pingud98/OpenAutoChPiHat/README.md

# OpenAutoChPiHat
A Raspberry Pi Hat designed for open hardware and open software car sharing

It's now featured in the SEEED fusion gallery: https://www.seeedstudio.com/Open-Car-Sharing-Hardware-Module-OpenAuto-c-g-1036303
