pingud98/OpenAutoChPiHat/openautopihatv1point2x.pdf

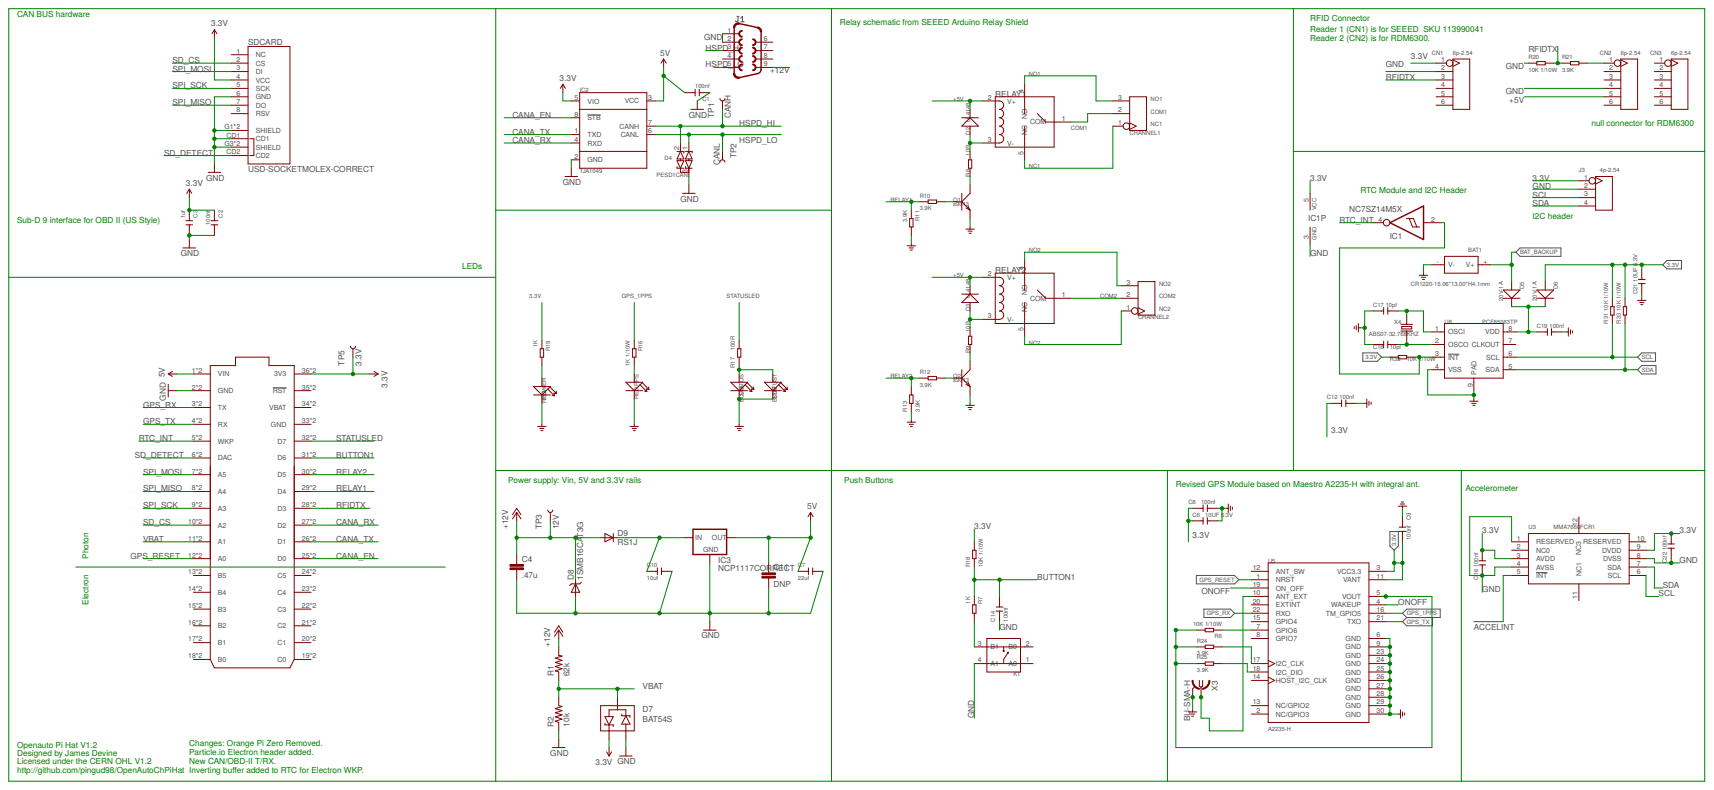
[picture p1: page 1]

USD-SOCKETMOLEX-CORRECT GND

Sub-D 9 interface for OBD II (US Style)

Revised GPS Module based on Maestro A2235-H with integral ant.

http://github.com/pingud98/OpenAutoChPiHat Changes: Orange Pi Zero Removed. Particle.io Electron header added. New CAN/OBD-II T/RX.
Openauto Pi Hat V1.2 Designed by James Devine
Licensed under the CERN OHL V1.2

Inverting buffer added to RTC for Electron WKP.
