pingud98/OpenAutoChPiHat/openautopihatv1point1brd.pdf

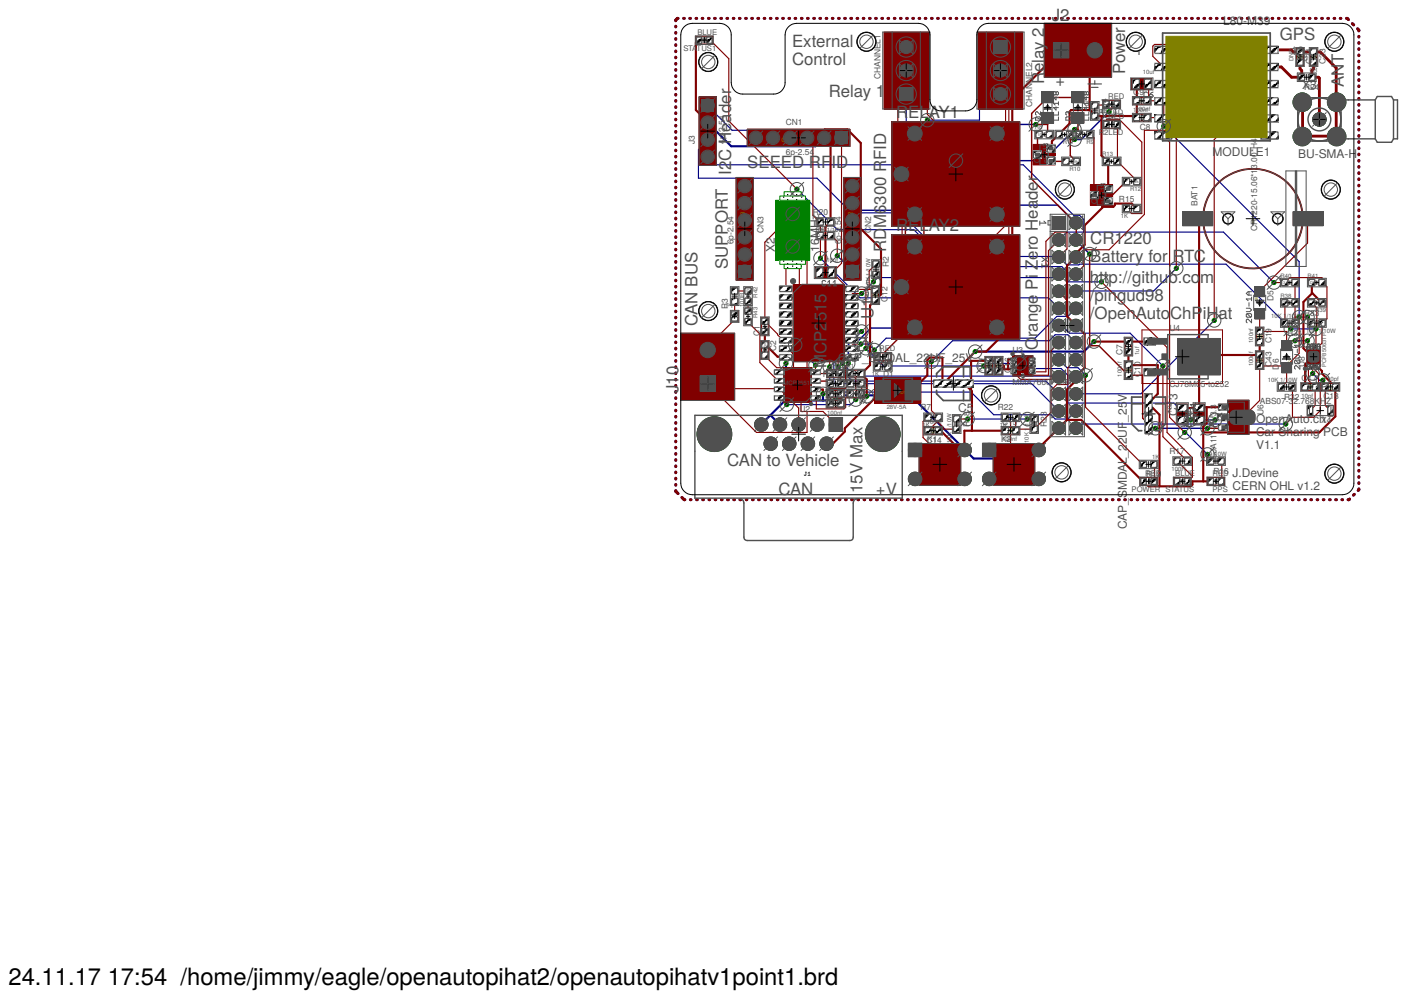
[picture p2: page 1]

Orange Pi Zero Header

3.9k | DNP

RED R1

OpenAuto.ch Car Sharing PCB
J.Devine CERN OHL v1.2

24.11.17 17:54 /home/jimmy/eagle/openautopihat2/openautopihatv1point1.brd
