pingud98/OpenAutoChPiHat/openautopihatv1point1.pdf

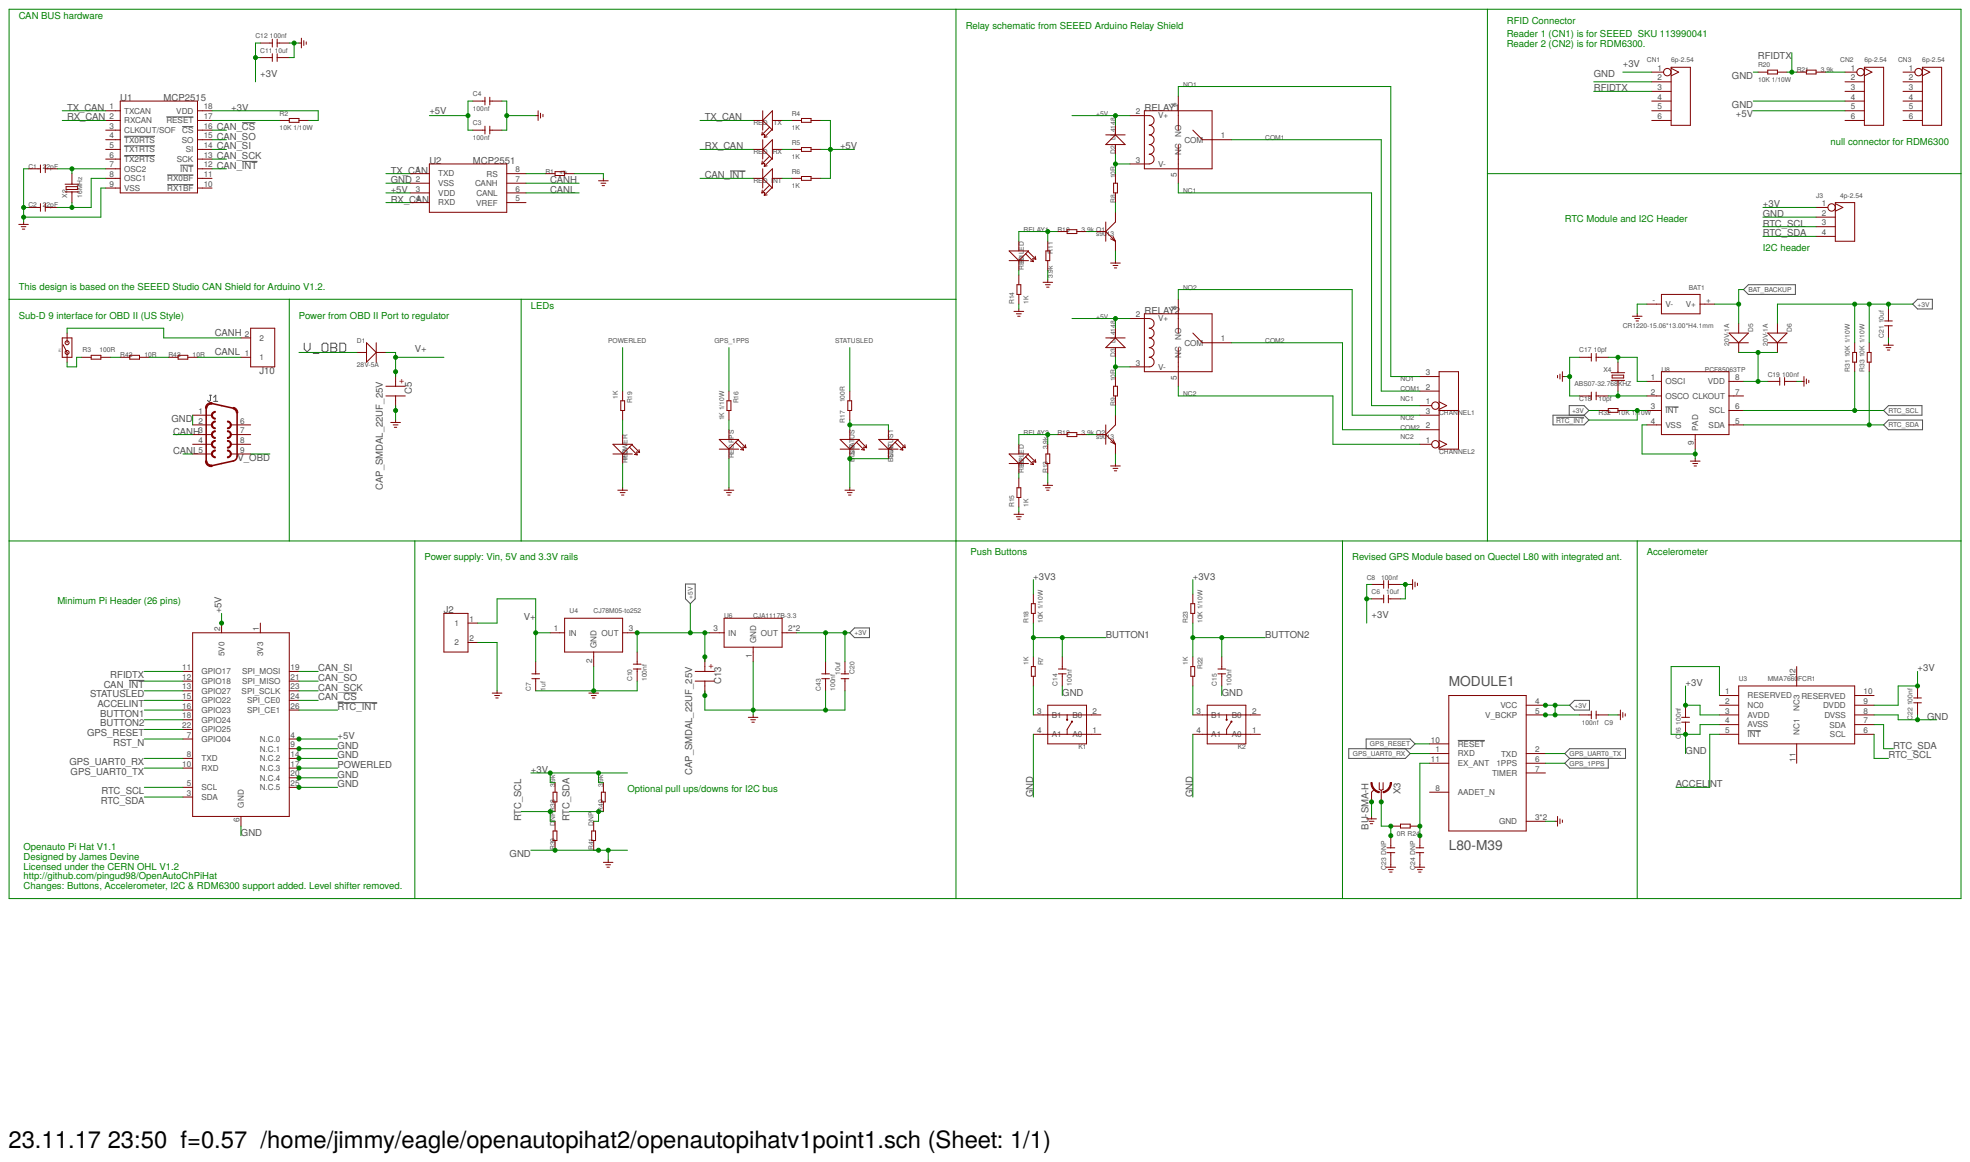
[picture p3: page 1]

RTC Module and I2C Header

Revised GPS Module based on Quectel L80 with integrated ant. Minimum Pi Header (26 pins)

Optional pull ups/downs for I2C bus Openauto Pi Hat V1.1 Designed by James Devine

Licensed under the CERN OHL V1.2
http://github.com/pingud98/OpenAutoChPiHat Changes: Buttons, Accelerometer, I2C & RDM6300 support added. Level shifter removed.

23.11.17 23:50 f=0.57 /home/jimmy/eagle/openautopihat2/openautopihatv1point1.sch (Sheet: 1/1)
