pingud98/OpenAutoChPiHat/openautopihat.pdf

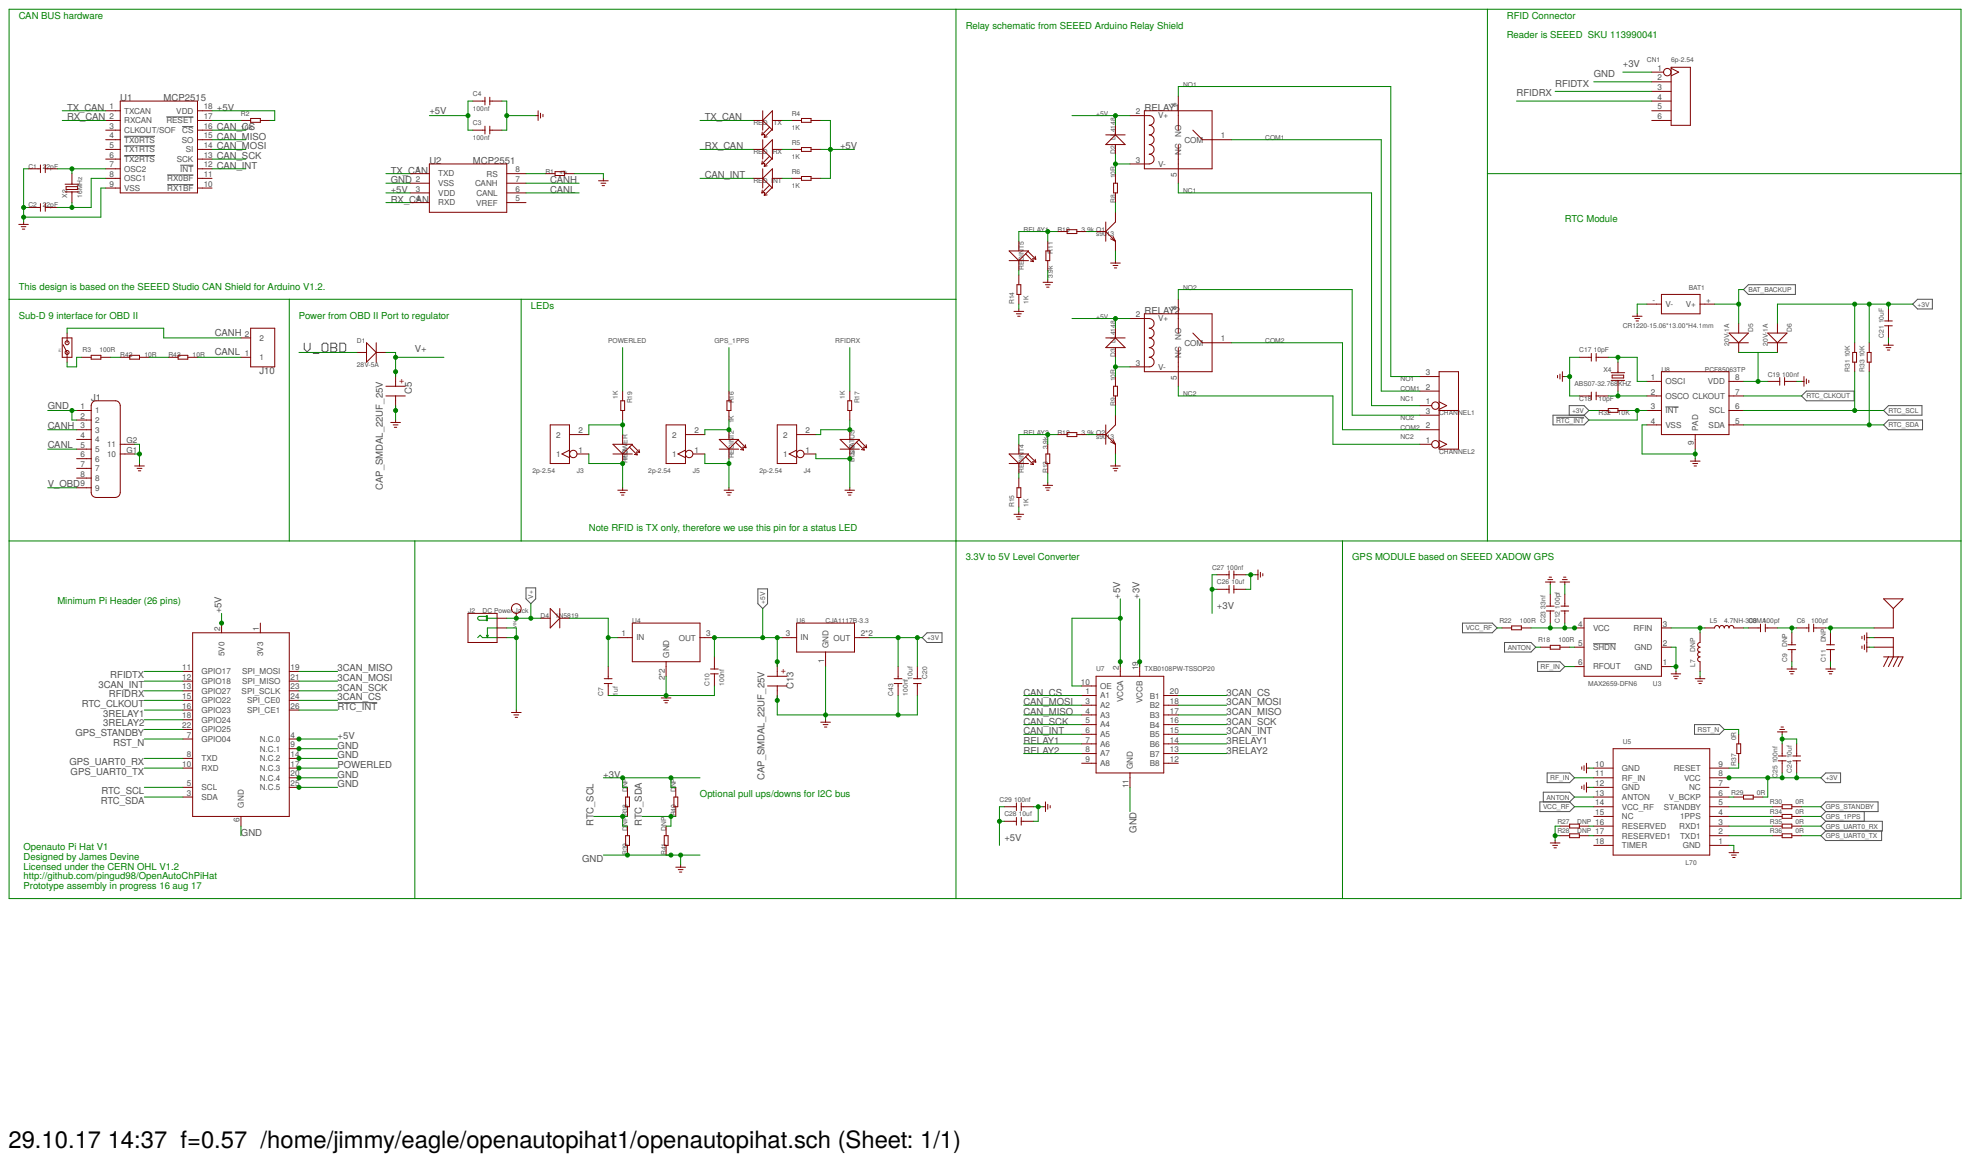
[picture p4: page 1]

Note RFID is TX only, therefore we use this pin for a status LED

DNP DNP

Optional pull ups/downs for I2C bus Openauto Pi Hat V1 Designed by James Devine

Licensed under the CERN OHL V1.2
http://github.com/pingud98/OpenAutoChPiHat Prototype assembly in progress 16 aug 17

29.10.17 14:37 f=0.57 /home/jimmy/eagle/openautopihat1/openautopihat.sch (Sheet: 1/1)
