pingud98/OpenAutoChPiHat/openautopihatv1point2x.brd

## EAGLE design openautopihatv1point2x.brd (2017-12-10)

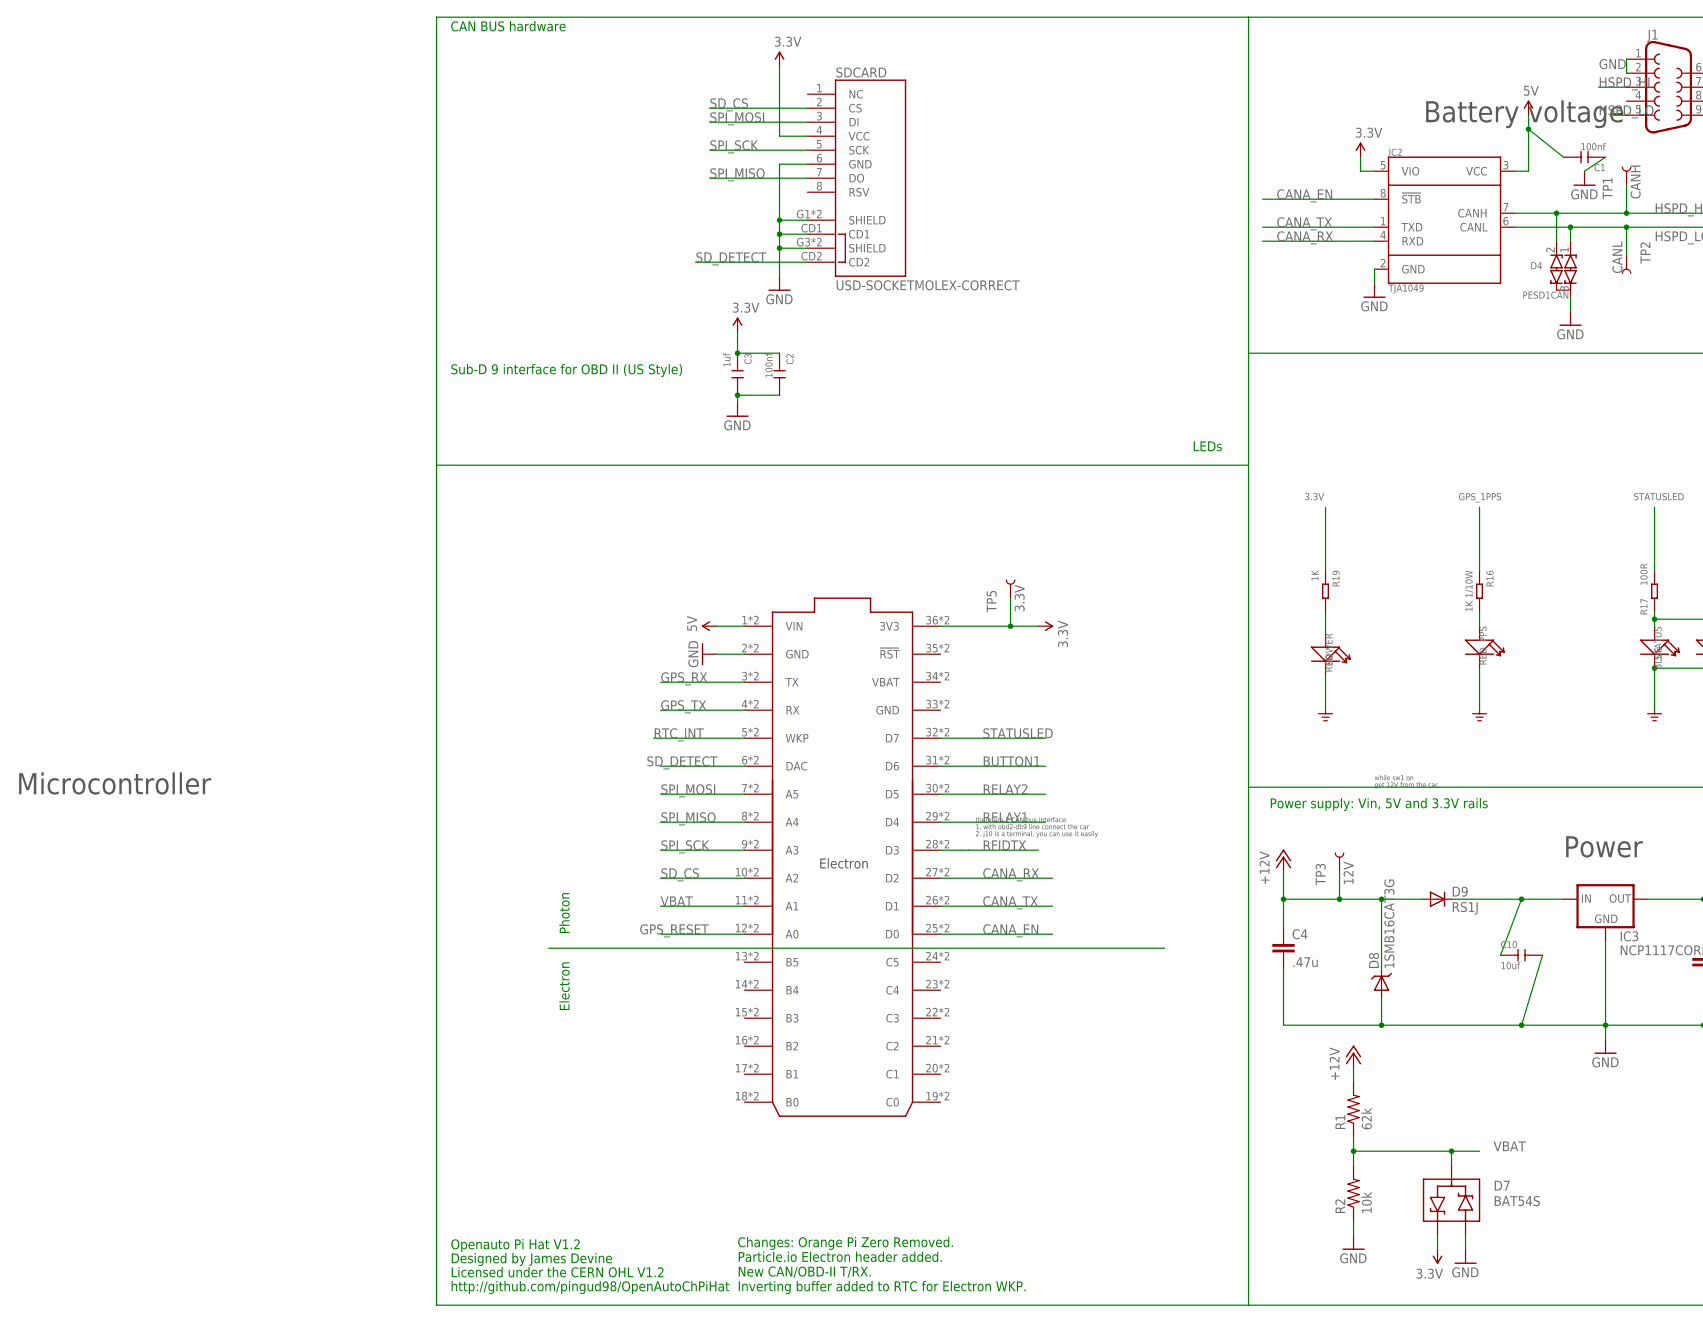
[picture p5: schematic openautopihatv1point2x.sch, part in row 1, column 1]

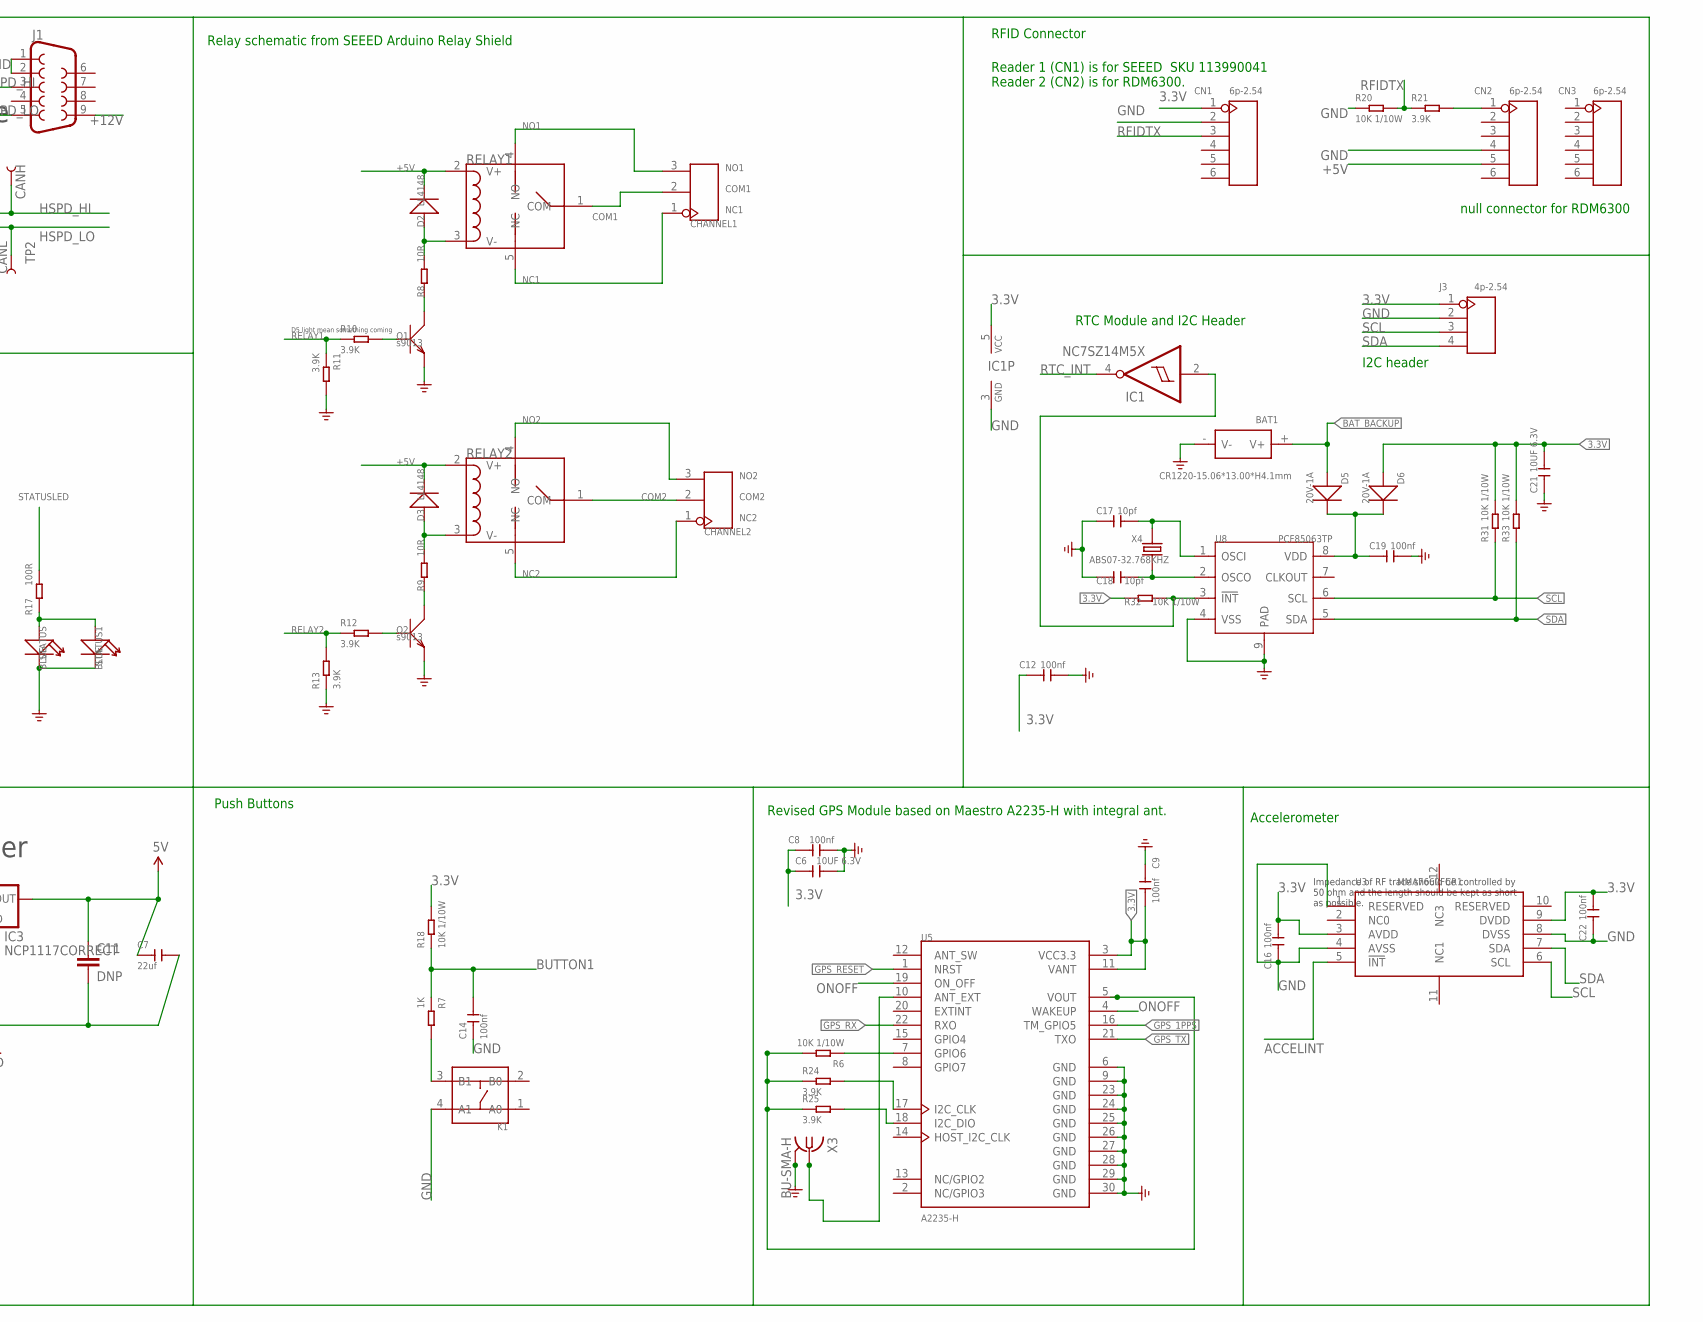
[picture p6: schematic openautopihatv1point2x.sch, part in row 1, column 2]

Parts:
BAT1: CR1220-15.06*13.00*H4.1mm; BAT2P-SMD-16.4-CR1220
C1, C2: 100nf; C0603; PARTNO 08055C104KAT2A
C3: 1uf; C0603; PARTNO CC0805KKX7R7BB105
C4: .47u; C0805; PARTNO C0805C474K5RACTU
C6, C21: 10UF 6.3V; C0603
C7: 22uf; C0805; PARTNO GRM219R61A226MEA0D
C8, C9, C12, C14, C16, C19, C22: 100nf; C0603
C10: 10uf; C0805; PARTNO GRM21BR6YA106KE43L
C11: DNP; C0805; PARTNO GRM219R61A226MEA0D
C17, C18: 10pf; C0603
CHANNEL1, CHANNEL2: SCREW-TERMINAL-3P'3.5'; 3P-3.5
CN1, CN2, CN3: 6p-2.54; H6-2.54
D2, D3: LL4148; LL-34
D4: PESD1CAN; SOT23; PARTNO PESD1CAN-215
D5, D6: 20V-1A; SOD-123
D7: BAT54S; SOT23; PARTNO BAT54S-7-F
D8: 1SMB16CAT3G; SMB-DIODE; PARTNO 1SMB16CAT3G
D9: RS1J; SMA-DIODE; PARTNO RS1J-E3/5AT
ELECTRON: ELECTRON_WITH_EXTERNAL_HEADERS; ELECTRON_EXTERNAL; PARTNO PPTC181LFBN-RC
IC1: NC7SZ14M5X; SOT23-5
IC2: TJA1049; SO8; PARTNO TJA1049T-118
IC3: NCP1117CORRECT; SOT223; PARTNO NCP1117LPST50T3G
J1: DB9MALE; DB9_MALE
J3: 4p-2.54; H4-2.54
K1: DIP-SWITCH-TACTILE-SPST-NO/TS-1109(4P-D6.0MM)'TS-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; SW4-6.0X6.0X5.0MM
POWER: RED; LED-0603
PPS: RED; LED-0603
Q1, Q2: s9013; SOT23
R1: 62k; R0805; PARTNO ERJ-6ENF6202V
R2: 10k; R0805; PARTNO ERJ-6ENF1002V
R6, R18, R20, R31, R32, R33: 10K 1/10W; R0603
R7, R19: 1K; R0603
R8, R9: 10R; R0603
R10, R11, R12, R13, R21, R24, R25: 3.9K; R0603
R16: 1K 1/10W; R0603
R17: 100R; R0603
RELAY1, RELAY2: RELAY-HLS8L-DC5V-S-C; 5P-19.0X15.5X15.8H
SDCARD: USD-SOCKETMOLEX-CORRECT; MICRO-SD-MOLEX-CORRECT; PARTNO 1040310811
STATUS, STATUS1: BLUE; LED-0603
TP1: CANH; PAD.03X.03
TP2: CANL; PAD.03X.03
TP3: 12V; PAD.03X.03
TP5: 3.3V; PAD.03X.03
U3: MMA7660FCR1; DFN10-0.5-3.0X3.0MM
U5: A2235-H; XCVR_A2235-H
U8: PCF85063TP; HWSON8-0.5-2X3X0.75MM
X3: BU-SMA-H
X4: ABS07-32.768KHZ; X2-SMD-3.2X1.5X0.55MM

Connections:
3.3V: C2.1, C3.1, C6.1, C8.1, C9.2, C12.1, C16.2, C21.2, C22.2, CN1.1, D6.+, D7.2 (C1), ELECTRON.36 (3V3), ELECTRON.@36 (3V3), IC1.5 (VCC), IC2.5 (VIO), J3.1, R18.2, R19.1, R31.2, R32.1, R33.2, SDCARD.4 (VCC), TP5.P$1, U3.3 (AVDD), U3.9 (DVDD), U5.3 (VCC3.3), U5.11 (VANT)
5V: C1.2, C7.1, C11.1, ELECTRON.1 (VIN), ELECTRON.@1 (VIN), IC2.3 (VCC), IC3.2 (OUT), IC3.4 (OUT)
!RTC_INT: IC1.2 (I), R32.2, U8.3 (!INT)
+5V: CN2.5, D2.C (-), D3.C (-), RELAY1.2 (V+), RELAY2.2 (V+)
+12V: C4.1, D8.C, D9.A, J1.9, R1.2, TP3.P$1
ACCELINT: U3.5 (!INT)
BAT_BACKUP: BAT1.+ (V+), D5.+
BUTTON1: C14.2, ELECTRON.31 (D6), ELECTRON.@31 (D6), R7.1, R18.1
CANA_EN: ELECTRON.25 (D0), ELECTRON.@25 (D0), IC2.8 (!STB)
CANA_RX: ELECTRON.27 (D2), ELECTRON.@27 (D2), IC2.4 (RXD)
CANA_TX: ELECTRON.26 (D1), ELECTRON.@26 (D1), IC2.1 (TXD)
COM1: CHANNEL1.2, RELAY1.1 (COM)
COM2: CHANNEL2.2, RELAY2.1 (COM)
GND: BAT1.- (V-), C1.1, C2.2, C3.2, C4.2, C6.2, C7.2, C8.2, C9.1, C10.2, C11.2, C12.2, C14.1, C16.1, C17.1, C18.1, C19.2, C21.1, C22.1, CN1.2, CN2.4, D4.3 (COM), D7.1 (A2), D8.A, ELECTRON.2 (GND), ELECTRON.33 (GND), ELECTRON.@2 (GND), ELECTRON.@33 (GND), IC1.3 (GND), IC2.2 (GND), IC3.1 (GND), J1.1, J1.2, J3.2, K1.4 (A1), POWER.-, PPS.-, Q1.2 (E), Q2.2 (E), R2.1, R11.2, R13.1, R20.1, SDCARD.6 (GND), SDCARD.CD1, SDCARD.G1 (SHIELD), SDCARD.G2 (SHIELD), SDCARD.G3 (SHIELD), SDCARD.G4 (SHIELD), STATUS.-, STATUS1.-, U3.1 (RESERVED), U3.4 (AVSS), U3.8 (DVSS), U5.6 (GND), U5.9 (GND), U5.23 (GND), U5.24 (GND), U5.25 (GND), U5.26 (GND), U5.27 (GND), U5.28 (GND), U5.29 (GND), U5.30 (GND), U8.4 (VSS), U8.9 (PAD), X3.2, X3.3 (2), X3.4 (2), X3.5 (2)
GPS_1PPS: R16.1, U5.16 (TM_GPIO5)
GPS_RESET: ELECTRON.12 (A0), ELECTRON.@12 (A0), U5.1 (NRST)
GPS_RX: ELECTRON.3 (TX), ELECTRON.@3 (TX), U5.22 (RXO)
GPS_TX: ELECTRON.4 (RX), ELECTRON.@4 (RX), U5.21 (TXO)
HSPD_HI: D4.2 (C2), IC2.7 (CANH), J1.3, TP1.P$1
HSPD_LO: D4.1 (C1), IC2.6 (CANL), J1.5, TP2.P$1
unnamed: K1.3 (B1), R7.2
unnamed: Q2.1 (B), R12.2
unnamed: D3.A (+), R9.2, RELAY2.3 (V-)
unnamed: Q1.3 (C), R8.1
unnamed: D2.A (+), R8.2, RELAY1.3 (V-)
unnamed: Q2.3 (C), R9.1
unnamed: PPS.+, R16.2
unnamed: R17.2, STATUS.+, STATUS1.+
unnamed: U5.10 (ANT_EXT), X3.1
unnamed: R6.2, R24.1, R25.1, U5.5 (VOUT)
unnamed: R6.1, U5.7 (GPIO6)
unnamed: Q1.1 (B), R10.2
unnamed: CN2.1, R21.2
unnamed: R24.2, U5.17 (I2C_CLK)
unnamed: R25.2, U5.18 (I2C_DIO)
unnamed: POWER.+, R19.2
unnamed: C18.2, U8.2 (OSCO), X4.1
unnamed: C17.2, U8.1 (OSCI), X4.2
unnamed: C10.1, D9.C, IC3.3 (IN)
unnamed: C19.1, D5.-, D6.-, U8.8 (VDD)
NC1: CHANNEL1.1, RELAY1.5 (NC)
NC2: CHANNEL2.1, RELAY2.5 (NC)
NO1: CHANNEL1.3, RELAY1.4 (NO)
NO2: CHANNEL2.3, RELAY2.4 (NO)
ONOFF: U5.4 (WAKEUP), U5.19 (ON_OFF)
RELAY1: ELECTRON.29 (D4), ELECTRON.@29 (D4), R10.1, R11.1
RELAY2: ELECTRON.30 (D5), ELECTRON.@30 (D5), R12.1, R13.2
RFIDTX: CN1.3, ELECTRON.28 (D3), ELECTRON.@28 (D3), R20.2, R21.1
RTC_INT: ELECTRON.5 (WKP), ELECTRON.@5 (WKP), IC1.4 (O)
SCL: J3.3, R31.1, U3.6 (SCL), U8.6 (SCL)
SDA: J3.4, R33.1, U3.7 (SDA), U8.5 (SDA)
SD_CS: ELECTRON.10 (A2), ELECTRON.@10 (A2), SDCARD.2 (CS)
SD_DETECT: ELECTRON.6 (DAC), ELECTRON.@6 (DAC), SDCARD.CD2
SPI_MISO: ELECTRON.8 (A4), ELECTRON.@8 (A4), SDCARD.7 (DO)
SPI_MOSI: ELECTRON.7 (A5), ELECTRON.@7 (A5), SDCARD.3 (DI)
SPI_SCK: ELECTRON.9 (A3), ELECTRON.@9 (A3), SDCARD.5 (SCK)
STATUSLED: ELECTRON.32 (D7), ELECTRON.@32 (D7), R17.1
VBAT: D7.3 (COM), ELECTRON.11 (A1), ELECTRON.34 (VBAT), ELECTRON.@11 (A1), ELECTRON.@34 (VBAT), R1.1, R2.2

Notes on the sheet:
D5 light mean something coming
CAN BUS hardware
there are 2 CAN bus interface:
1. with obd2-db9 line connect the car
2. j10 is a terminal, you can use it easily
Sub-D 9 interface for OBD II (US Style)
get 12V from the car,
while sw1 on
Relay schematic from SEEED Arduino Relay Shield
RFID Connector
Reader 1 (CN1) is for SEEED SKU 113990041 Reader 2 (CN2) is for RDM6300.
RTC Module and I2C Header
Impedance of RF trace should be controlled by 50 ohm and the length should be kept as short as possible.
Revised GPS Module based on Maestro A2235-H with integral ant.
LEDs
Openauto Pi Hat V1.2
Designed by James Devine
Licensed under the CERN OHL V1.2
http://github.com/pingud98/OpenAutoChPiHat
Changes: Orange Pi Zero Removed. Particle.io Electron header added. New CAN/OBD-II T/RX. Inverting buffer added to RTC for Electron WKP.
Push Buttons
Accelerometer
Power supply: Vin, 5V and 3.3V rails
null connector for RDM6300
I2C header
Battery voltage
Microcontroller
Power
Photon
Electron

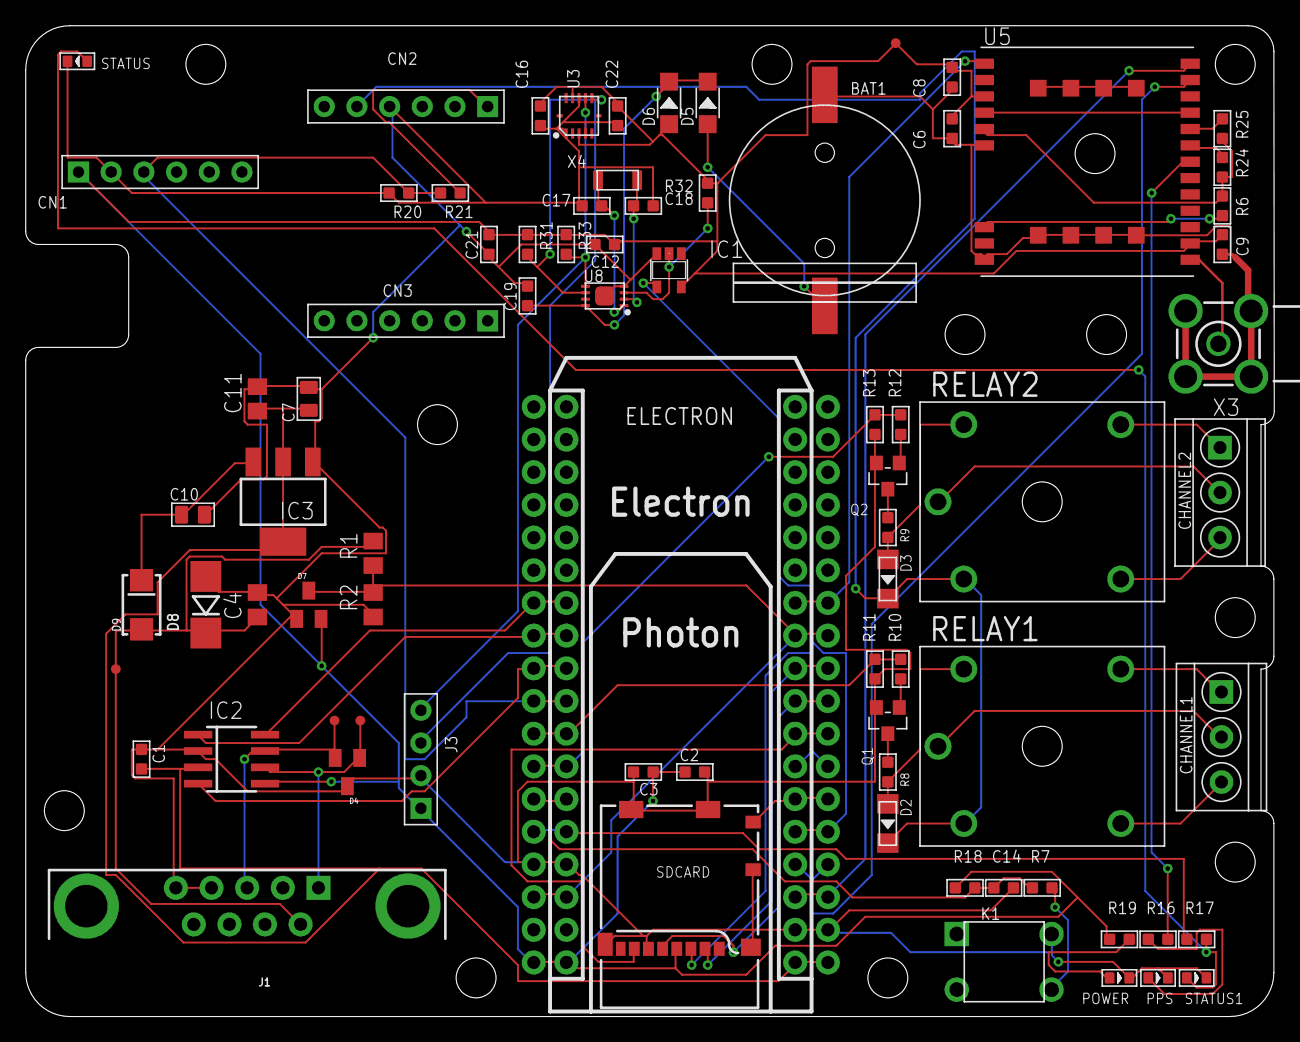
[picture p7: board openautopihatv1point2x.brd from above]

Board: 2 copper layers, 97.0 x 77.0 mm, 78 parts (0 on the bottom side), 57 nets.
