pingud98/OpenAutoChPiHat/openautopihatv1point1.brd

## EAGLE design openautopihatv1point1.brd (2017-11-23)

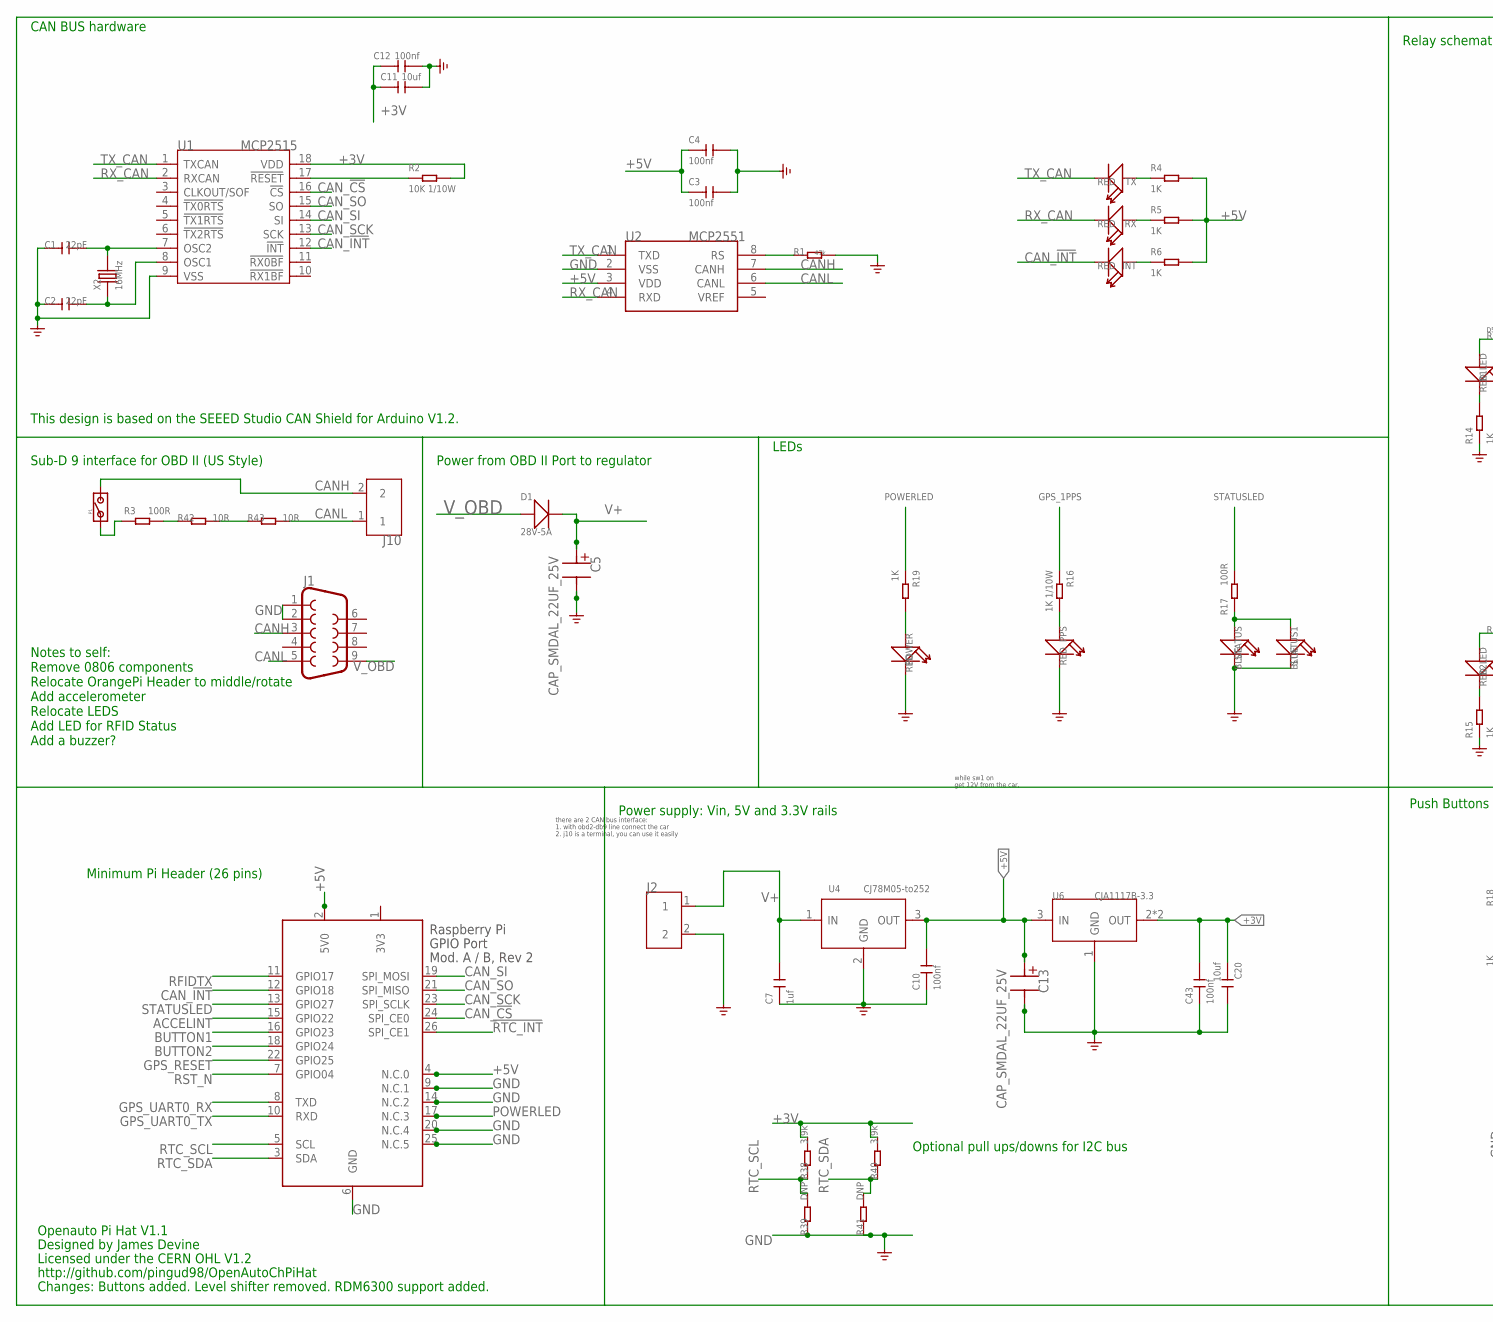
[picture p8: schematic openautopihatv1point1.sch, part in row 1, column 1]

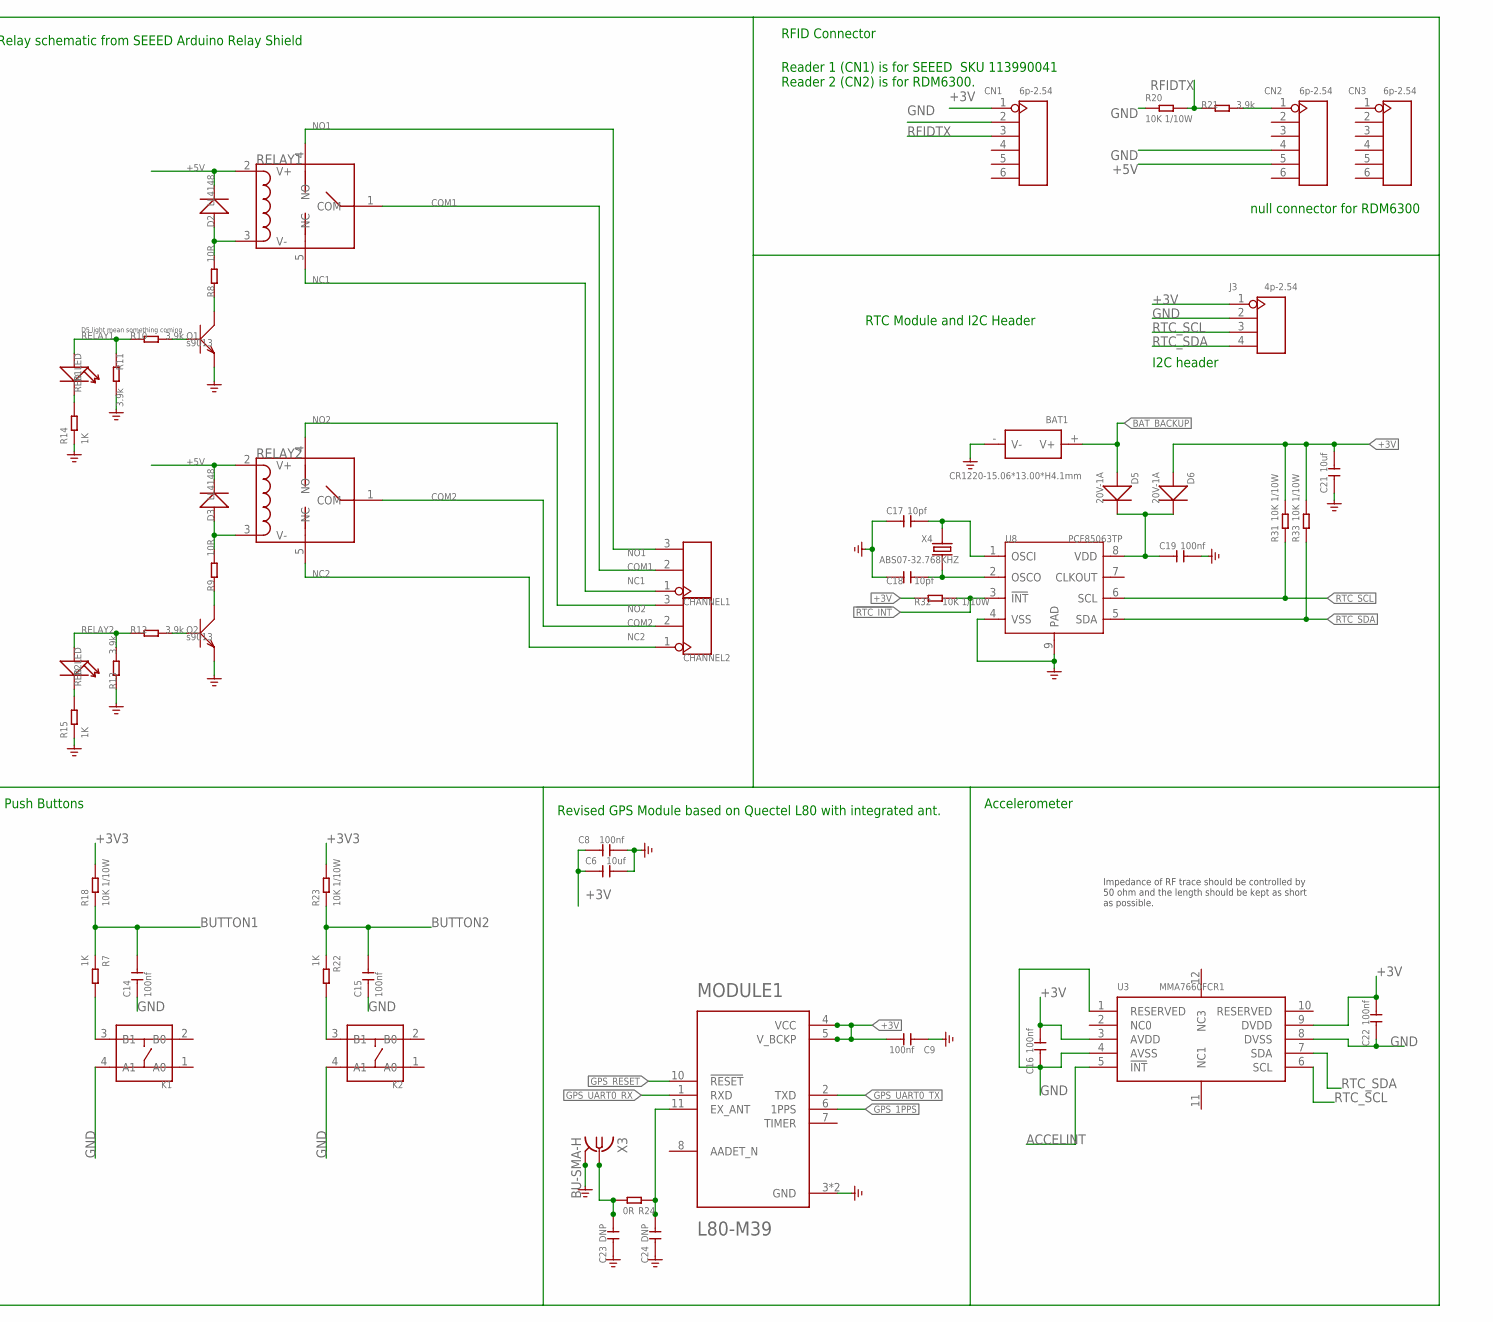
[picture p9: schematic openautopihatv1point1.sch, part in row 1, column 2]

Parts:
BAT1: CR1220-15.06*13.00*H4.1mm; BAT2P-SMD-16.4-CR1220
C1, C2: 22pF; C0603
C3, C4, C8, C9, C10, C12, C14, C15, C16, C19, C22, C43: 100nf; C0603
C5, C13: CAP_SMDAL_22UF_25V; CAP_SMD_AL_D50
C6, C11, C20, C21: 10uf; C0805
C7: 1uf; C0603
C17, C18: 10pf; C0603
C23, C24: DNP; C0603
CHANNEL1, CHANNEL2: SCREW-TERMINAL-3P'3.5'; 3P-3.5
CN1, CN2, CN3: 6p-2.54; H6-2.54
D1: 28V-5A; DO-214AA
D2, D3: LL4148; LL-34
D5, D6: 20V-1A; SOD-123
INT: RED; LED-0603
J1: DB9MALE; DB9_MALE
J2, J10: SCREW-TERMINAL-2P5.0; 2P-5.0
J3: 4p-2.54; H4-2.54
K1, K2: DIP-SWITCH-TACTILE-SPST-NO/TS-1109(4P-D6.0MM)'TS-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; SW4-6.0X6.0X5.0MM
MODULE1: L80-M39; QUECTEL_L80-M39
P1: PAD-JUMPER-2P; 2P-SMD-1.78X1.27
POWER: RED; LED-0603
PPS: RED; LED-0603
Q1, Q2: s9013; SOT23
R1: 47k; 0603
R1LED, R2LED: RED; LED-0603
R2, R18, R20, R23, R31, R32, R33: 10K 1/10W; R0603
R3, R17: 100R; R0603
R4, R5, R6, R7, R14, R15, R19, R22: 1K; R0603
R8, R9, R42, R43: 10R; R0603
R10, R11, R12, R13, R21, R38, R40: 3.9k; R0603
R16: 1K 1/10W; R0603
R24: 0R; R0603
R39, R41: DNP; R0603
RELAY1, RELAY2: RELAY-HLS8L-DC5V-S-C; 5P-19.0X15.5X15.8H
RX: RED; LED-0603
STATUS, STATUS1: BLUE; LED-0603
TX: RED; LED-0603
U1: MCP2515; SOIC18
U2: MCP2551; SOIC8-6.0
U3: MMA7660FCR1; DFN10-0.5-3.0X3.0MM
U4: CJ78M05-to252; TO-252
U6: CJA1117B-3.3; SOT-89
U8: PCF85063TP; HWSON8-0.5-2X3X0.75MM
X1: RASPI_GPIO_AB_PIN
X2: 16MHz; HC49/S
X3: BU-SMA-H
X4: ABS07-32.768KHZ; X2-SMD-3.2X1.5X0.55MM

Connections:
3V3: X1.1 (3V3)
!RTC_INT: R32.2, U8.3 (!INT), X1.26 (SPI_CE1)
+3V: C6.1, C8.1, C9.2, C11.1, C12.1, C16.2, C20.1, C21.2, C22.2, C43.2, CN1.1, D6.+, J3.1, MODULE1.4 (VCC), MODULE1.5 (V_BCKP), R2.2, R31.2, R32.1, R33.2, R38.2, R40.2, U1.18 (VDD), U3.3 (AVDD), U3.9 (DVDD), U6.2 (OUT), U6.4 (OUT)
+3V3: R18.2, R23.2
+5V: C3.1, C4.1, C10.2, C13.P$P, CN2.5, D2.C (-), D3.C (-), R4.2, R5.2, R6.2, RELAY1.2 (V+), RELAY2.2 (V+), U2.3 (VDD), U4.3 (OUT), U6.3 (IN), X1.2 (5V0), X1.4 (N.C.0)
ACCELINT: U3.5 (!INT), X1.15 (GPIO22)
BAT_BACKUP: BAT1.+ (V+), D5.+
BUTTON1: C14.2, R7.1, R18.1, X1.16 (GPIO23)
BUTTON2: C15.2, R22.1, R23.1, X1.18 (GPIO24)
CANH: J1.3, J10.2, P1.2, U2.7 (CANH)
CANL: J1.5, J10.1, R43.2, U2.6 (CANL)
CAN_!CS: U1.16 (!CS), X1.24 (SPI_CE0)
CAN_!INT: INT.-, U1.12 (!INT), X1.12 (GPIO18)
CAN_SCK: U1.13 (SCK), X1.23 (SPI_SCLK)
CAN_SI: U1.14 (SI), X1.19 (SPI_MOSI)
CAN_SO: U1.15 (SO), X1.21 (SPI_MISO)
COM1: CHANNEL1.2, RELAY1.1 (COM)
COM2: CHANNEL2.2, RELAY2.1 (COM)
GND: BAT1.- (V-), C1.1, C2.1, C3.2, C4.2, C5.P$M, C6.2, C7.1, C8.2, C9.1, C10.1, C11.2, C12.2, C13.P$M, C14.1, C15.1, C16.1, C17.1, C18.1, C19.2, C20.2, C21.1, C22.1, C23.1, C24.1, C43.1, CN1.2, CN2.4, J1.1, J1.2, J2.2, J3.2, K1.4 (A1), K2.4 (A1), MODULE1.3 (GND), MODULE1.12 (GND), POWER.-, PPS.-, Q1.2 (E), Q2.2 (E), R1.2, R11.2, R13.1, R14.1, R15.1, R20.1, R39.1, R41.1, STATUS.-, STATUS1.-, U1.9 (VSS), U2.2 (VSS), U3.1 (RESERVED), U3.4 (AVSS), U3.8 (DVSS), U4.2 (GND), U6.1 (GND), U8.4 (VSS), U8.9 (PAD), X1.6 (GND), X1.9 (N.C.1), X1.14 (N.C.2), X1.20 (N.C.4), X1.25 (N.C.5), X3.2, X3.3 (2), X3.4 (2), X3.5 (2)
GPS_1PPS: MODULE1.6 (1PPS), R16.1
GPS_RESET: MODULE1.10 (!RESET), X1.22 (GPIO25)
GPS_UART0_RX: MODULE1.1 (RXD), X1.8 (TXD)
GPS_UART0_TX: MODULE1.2 (TXD), X1.10 (RXD)
unnamed: K1.3 (B1), R7.2
unnamed: R4.1, TX.+
unnamed: Q2.1 (B), R12.2
unnamed: D3.A (+), R9.2, RELAY2.3 (V-)
unnamed: Q1.3 (C), R8.1
unnamed: D2.A (+), R8.2, RELAY1.3 (V-)
unnamed: Q2.3 (C), R9.1
unnamed: PPS.+, R16.2
unnamed: R17.2, STATUS.+, STATUS1.+
unnamed: R3.1, R42.1
unnamed: R1LED.-, R14.2
unnamed: R2LED.-, R15.2
unnamed: C24.2, MODULE1.11 (EX_ANT), R24.1
unnamed: R5.1, RX.+
unnamed: C1.2, U1.7 (OSC2), X2.2
unnamed: C2.2, U1.8 (OSC1), X2.1
unnamed: C23.2, R24.2, X3.1
unnamed: INT.+, R6.1
unnamed: R1.1, U2.8 (RS)
unnamed: Q1.1 (B), R10.2
unnamed: CN2.1, R21.2
unnamed: K2.3 (B1), R22.2
unnamed: POWER.+, R19.2
unnamed: P1.1, R3.2
unnamed: C18.2, U8.2 (OSCO), X4.1
unnamed: C17.2, U8.1 (OSCI), X4.2
unnamed: R42.2, R43.1
unnamed: C19.1, D5.-, D6.-, U8.8 (VDD)
NC1: CHANNEL1.1, RELAY1.5 (NC)
NC2: CHANNEL2.1, RELAY2.5 (NC)
NO1: CHANNEL1.3, RELAY1.4 (NO)
NO2: CHANNEL2.3, RELAY2.4 (NO)
POWERLED: R19.1, X1.17 (N.C.3)
RELAY1: R1LED.+, R10.1, R11.1
RELAY2: R2LED.+, R12.1, R13.2
RFIDTX: CN1.3, R20.2, R21.1, X1.11 (GPIO17)
RST_N: R2.1, U1.17 (!RESET), X1.7 (GPIO04)
RTC_SCL: J3.3, R31.1, R38.1, R39.2, U3.6 (SCL), U8.6 (SCL), X1.5 (SCL)
RTC_SDA: J3.4, R33.1, R40.1, R41.2, U3.7 (SDA), U8.5 (SDA), X1.3 (SDA)
RX_CAN: RX.-, U1.2 (RXCAN), U2.4 (RXD)
STATUSLED: R17.1, X1.13 (GPIO27)
TX_CAN: TX.-, U1.1 (TXCAN), U2.1 (TXD)
V+: C5.P$P, C7.2, D1.-, J2.1, U4.1 (IN)
V_OBD: D1.+, J1.9

Notes on the sheet:
D5 light mean something coming
CAN BUS hardware
there are 2 CAN bus interface:
1. with obd2-db9 line connect the car
2. j10 is a terminal, you can use it easily
Sub-D 9 interface for OBD II (US Style)
get 12V from the car,
while sw1 on
Power from OBD II Port to regulator
This design is based on the SEEED Studio CAN Shield for Arduino V1.2.
Relay schematic from SEEED Arduino Relay Shield
RFID Connector
Reader 1 (CN1) is for SEEED SKU 113990041 Reader 2 (CN2) is for RDM6300.
RTC Module and I2C Header
Impedance of RF trace should be controlled by 50 ohm and the length should be kept as short as possible.
Revised GPS Module based on Quectel L80 with integrated ant.
Minimum Pi Header (26 pins)
LEDs
Optional pull ups/downs for I2C bus
Openauto Pi Hat V1.1
Designed by James Devine
Licensed under the CERN OHL V1.2
http://github.com/pingud98/OpenAutoChPiHat
Changes: Buttons added. Level shifter removed. RDM6300 support added.
Push Buttons
Accelerometer
Power supply: Vin, 5V and 3.3V rails
null connector for RDM6300
Notes to self: Remove 0806 components Relocate OrangePi Header to middle/rotate Add accelerometer Relocate LEDS Add LED for RFID Status Add a buzzer?
I2C header

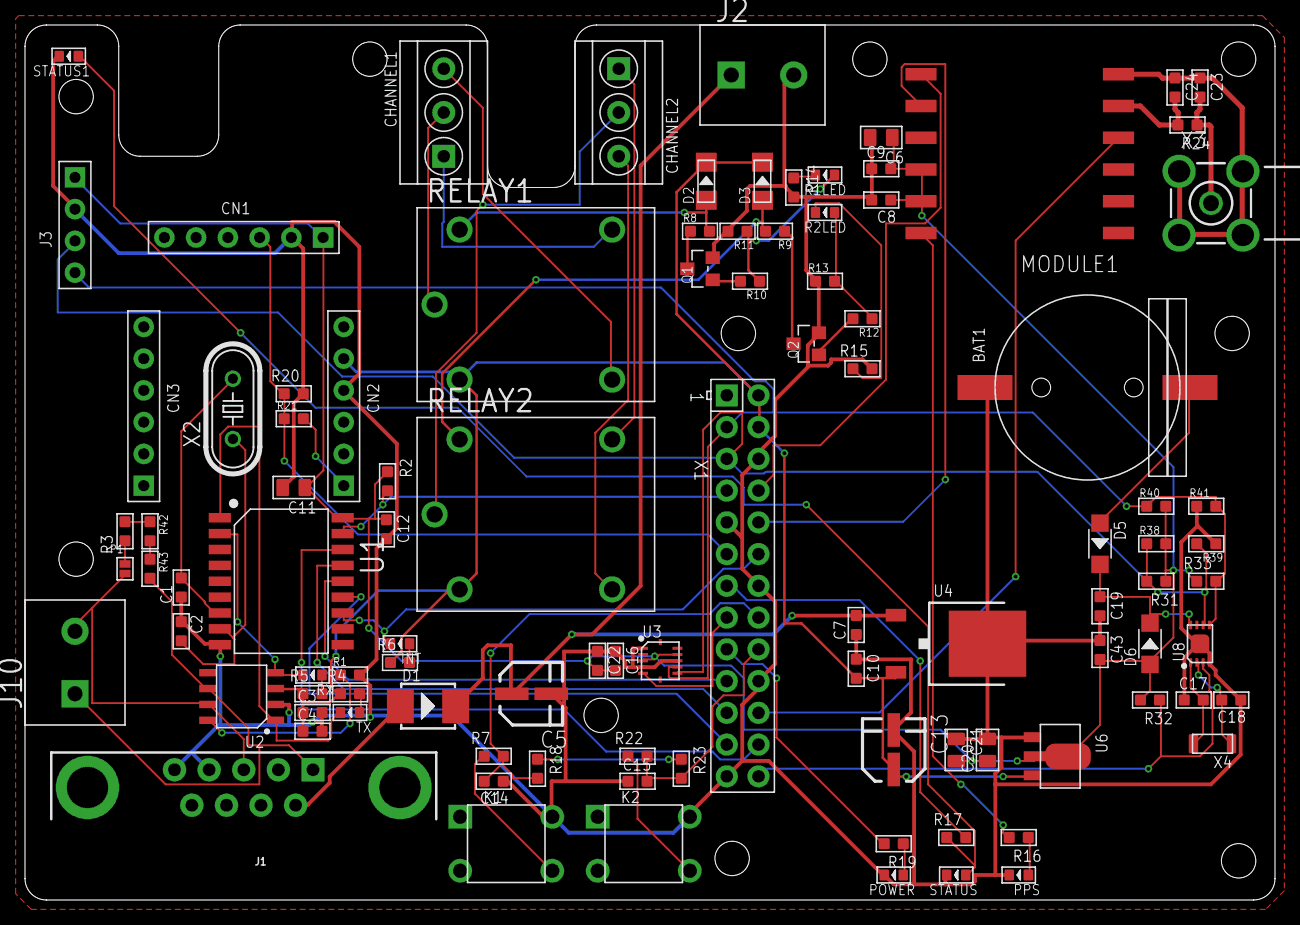
[picture p10: board openautopihatv1point1.brd from above]

Board: 2 copper layers, 100.0 x 70.0 mm, 100 parts (0 on the bottom side), 66 nets.
