pingud98/OpenAutoChPiHat/(commit log)

2017-08-02 EagleCad Schematic for main board
    First draft, incomplete.
    [openautopihat.sch]
2017-08-16 Schematic revised & completed. Layout in progress
    [openautopihat.brd, openautopihat.sch]
2017-10-29 As prototypes manufactured
    [openautopihat.brd, openautopihat.sch]
2017-11-13 Added BOM
    For production at SEEED studio
    [BOM.csv]
2017-11-20 Updated schematic based on hardware debug. Layout to follow.
    [openautopihatv1point1.sch]
2017-11-23 Version 1.1 design completed
    [openautopihatv1point1.brd, openautopihatv1point1.sch]
2017-12-10 Respin with Photon/Electron hardware
    [openautopihatv1point2x.brd, openautopihatv1point2x.sch]
